Marshall9570/Mirrorage/README.md

# Mirrorage
Smart Mirror Project 

View DIY PDF for detailed instruction
