Marshall9570/Mirrorage/Mirrorage Webpage Files/img/01d.png

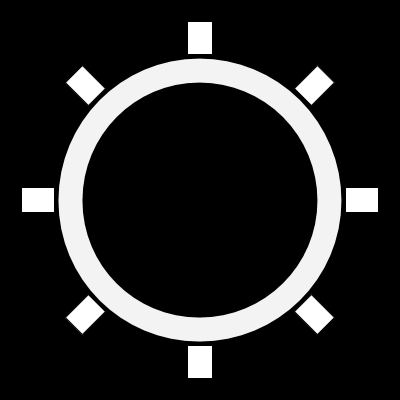
Mirrorage Webpage Files/img/01d.png
