Marshall9570/Mirrorage/Mirrorage Webpage Files/img/01n.png

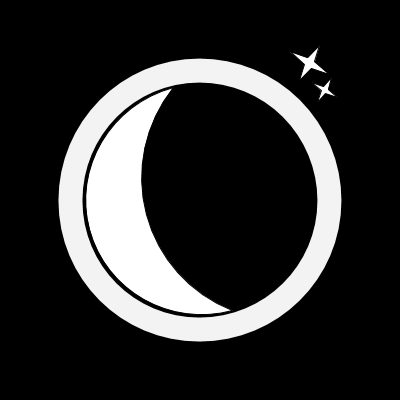
Mirrorage Webpage Files/img/01n.png
