Marshall9570/Mirrorage/Mirrorage Webpage Files/img/02d.png

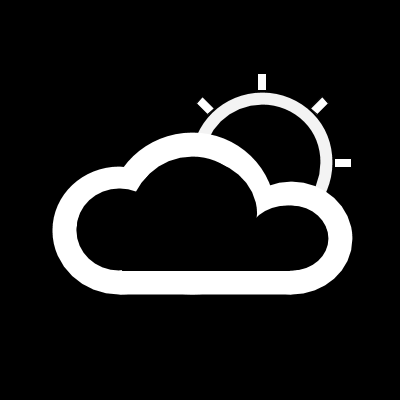
Mirrorage Webpage Files/img/02d.png
