Marshall9570/Mirrorage/Mirrorage Webpage Files/img/02n.png

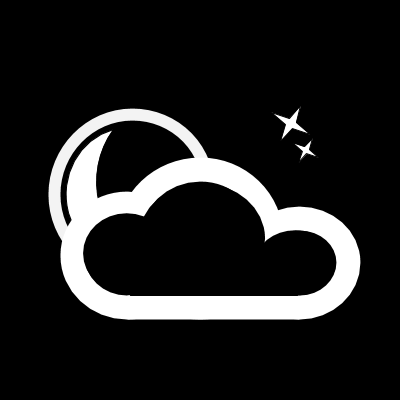
Mirrorage Webpage Files/img/02n.png
