Marshall9570/Mirrorage/Mirrorage Webpage Files/img/03d.png

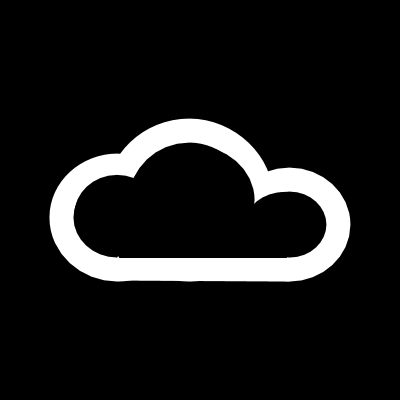
Mirrorage Webpage Files/img/03d.png
