Marshall9570/Mirrorage/Mirrorage Webpage Files/img/03n.png

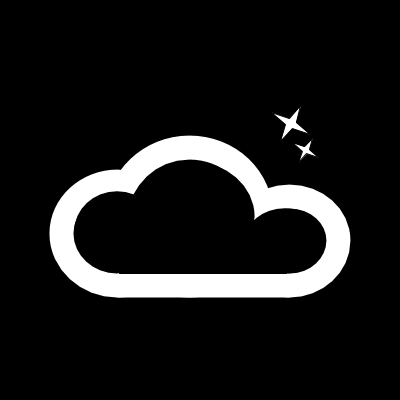
Mirrorage Webpage Files/img/03n.png
