Marshall9570/Mirrorage/Mirrorage Webpage Files/img/04d.png

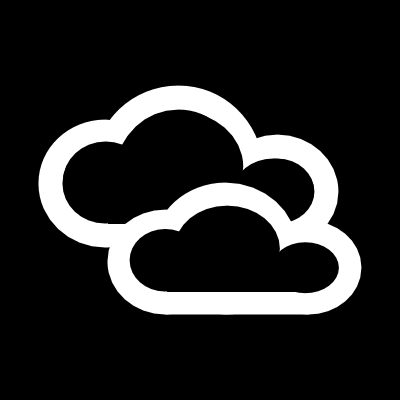
Mirrorage Webpage Files/img/04d.png
