Marshall9570/Mirrorage/Mirrorage Webpage Files/img/09d.png

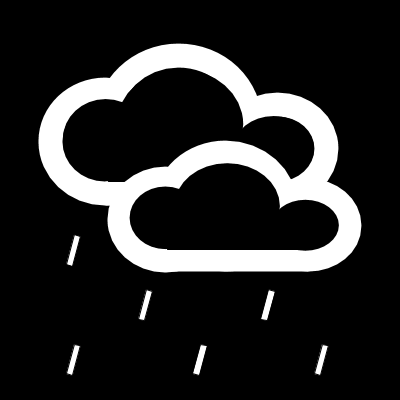
Mirrorage Webpage Files/img/09d.png
