Marshall9570/Mirrorage/Mirrorage Webpage Files/img/10d.png

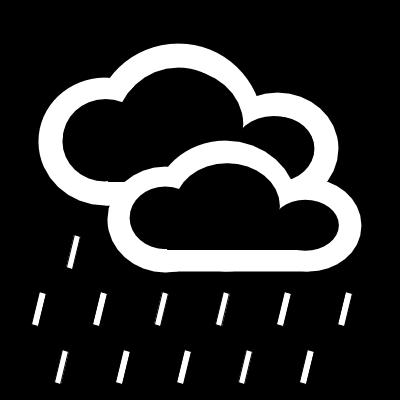
Mirrorage Webpage Files/img/10d.png
