Marshall9570/Mirrorage/Mirrorage Webpage Files/img/11d.png

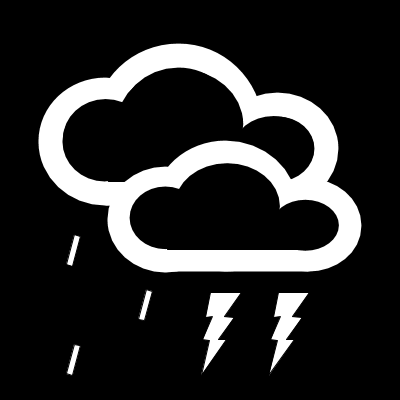
Mirrorage Webpage Files/img/11d.png
