Marshall9570/Mirrorage/Mirrorage Webpage Files/img/13d.png

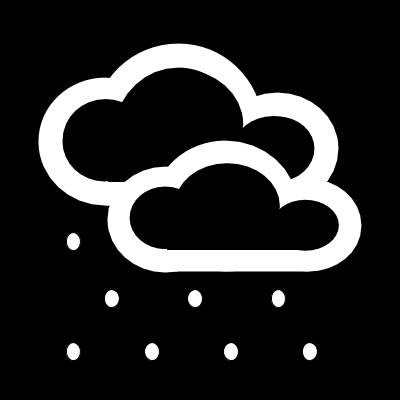
Mirrorage Webpage Files/img/13d.png
