Marshall9570/Mirrorage/Mirrorage Webpage Files/img/50d.png

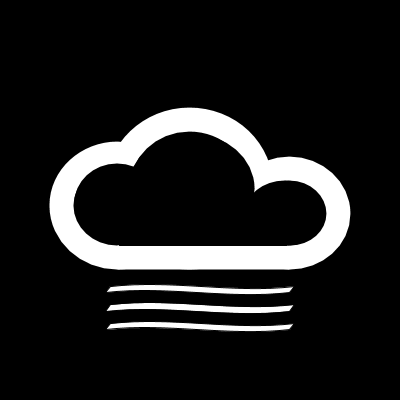
Mirrorage Webpage Files/img/50d.png
