Marshall9570/Mirrorage/Mirrorage Webpage Files/img/Humidity.png

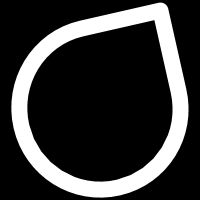
Mirrorage Webpage Files/img/Humidity.png
